LikeFall123/ImpedanceMeasMultiSine/Measurements/Multisine - Impedance/Impedancia mérés.docx

# Valós impedancián való mérés:

Párhuzamos/soros LR/CR impedancia mérése: L = 10 mH, C = 10 uF, R = 10 Ohm

## 1.2 darab szinusz. 5 paraméteres LSM illesztés:

f1 = 1 Hz, f2 = 10 Hz, fs = 1 kHz

Mikrovezérlő a mért impedancia alapján a kiválasztott modell paramétereit kiszámolja:

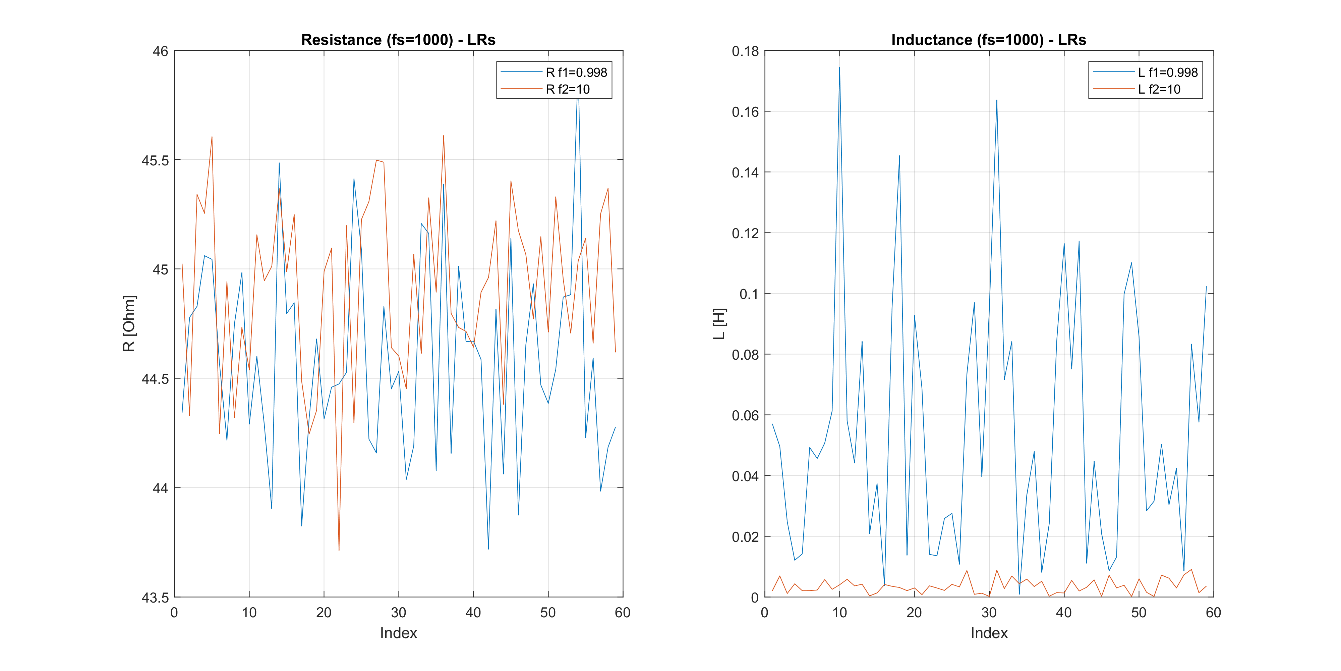
[picture p1: figure]
A képen szöveg, diagram, sor, Betűtípus látható Automatikusan generált leírás
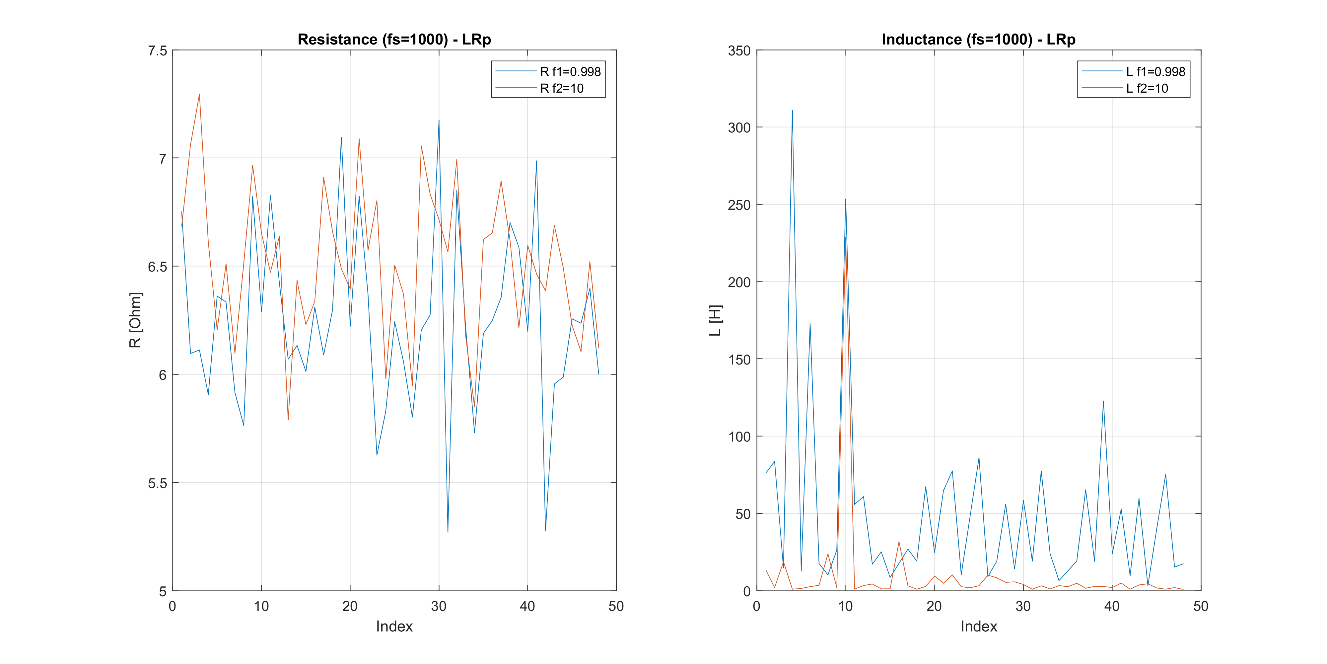
[picture p2: figure]
A képen szöveg, diagram, sor, Diagram látható Automatikusan generált leírás
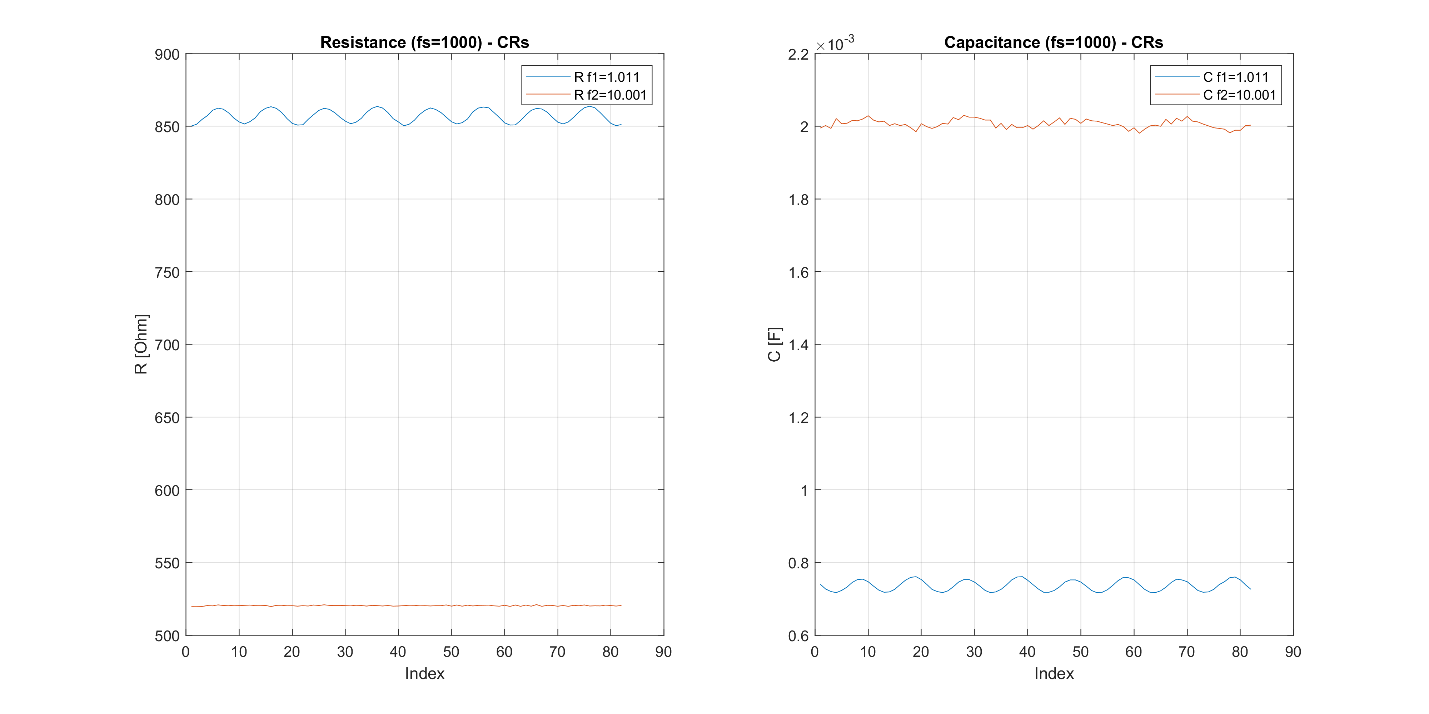
[picture p3: figure]
A képen szöveg, diagram, sor, Diagram látható Automatikusan generált leírás

C és S soros esetben 100 uF-al történt a mérés.

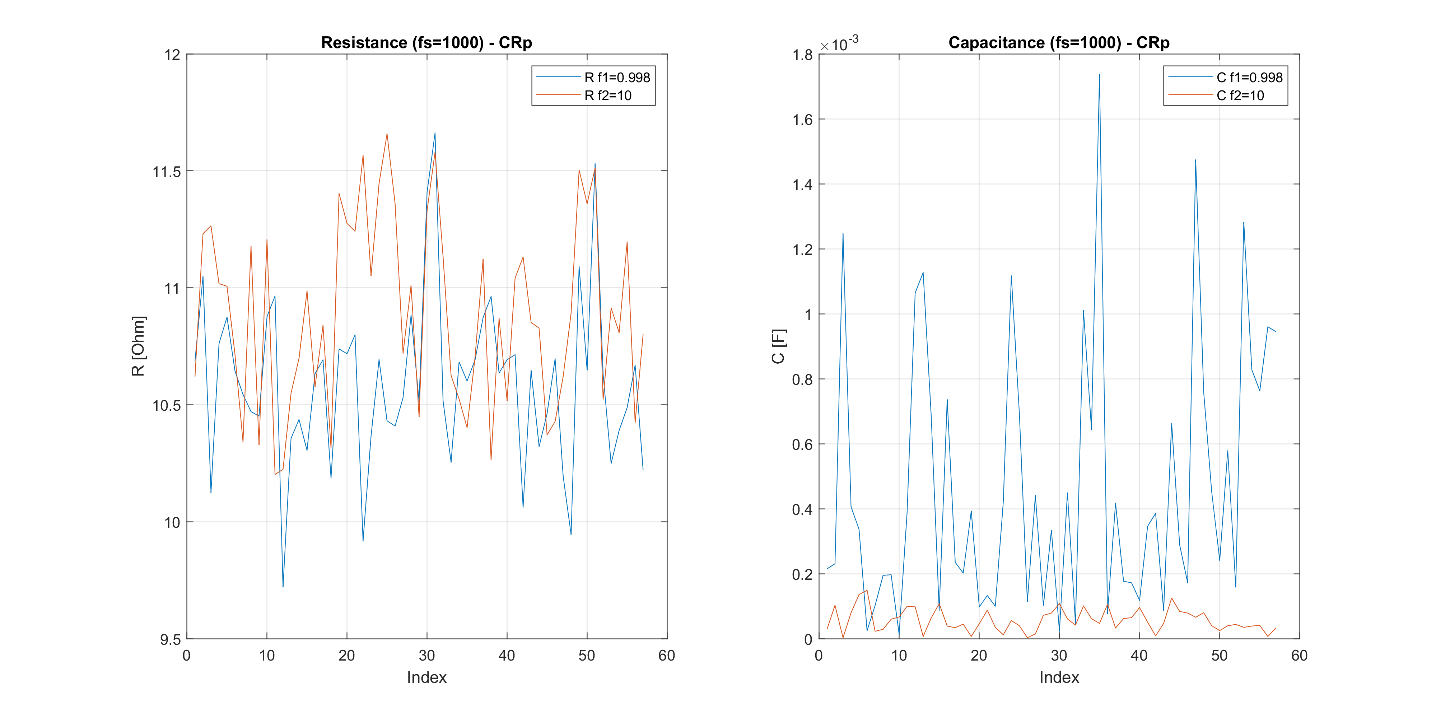
[picture p4: figure]
A képen szöveg, diagram, sor, Diagram látható Automatikusan generált leírás

## 2. Multiszinusz gerjesztés, majd FFT számolás

Legmegfelelőbbnek tűnő beállítás:

Bemenő jel: 10 Hz-től 200 Hz-ig, 10 Hz-enként egységnyi amplitúdójú szinuszok (random fázissal).

Az MCU kiszámolta az impedancia komplex spektrumát. MATLAB-ban kiértékelve a választott modell alapján.

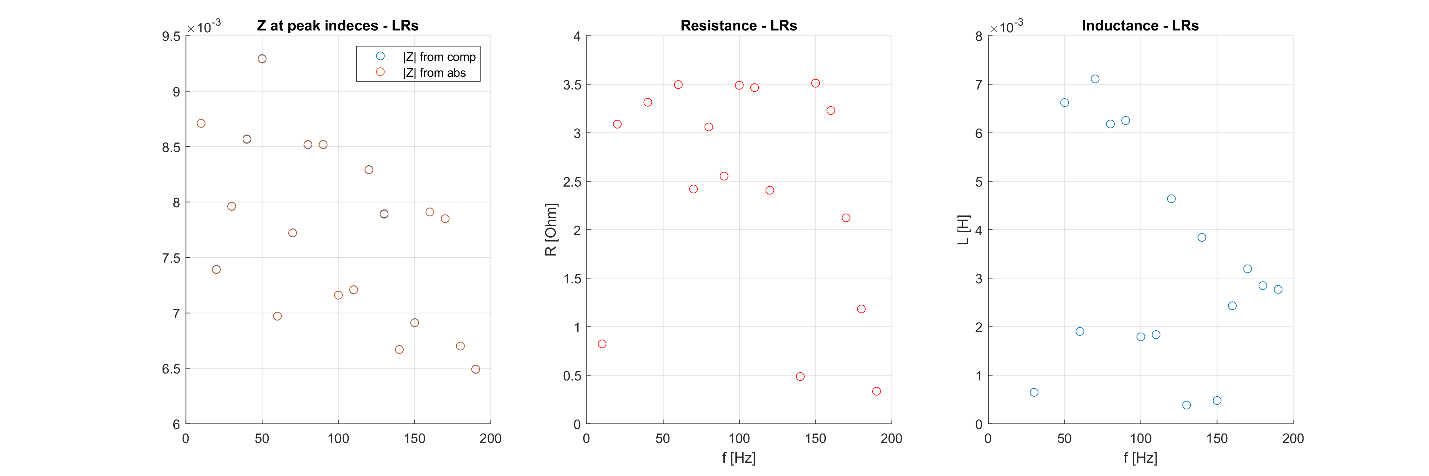
[picture p5: figure]
A képen szöveg, képernyőkép, diagram, sor látható Automatikusan generált leírás
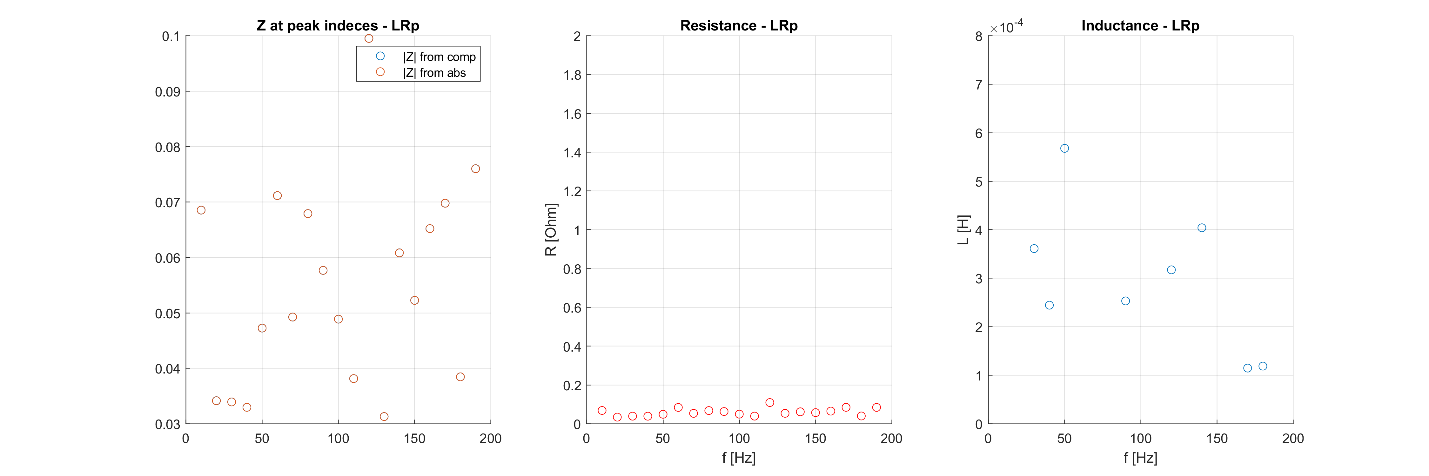
[picture p6: figure]
A képen szöveg, diagram, sor, képernyőkép látható Automatikusan generált leírás
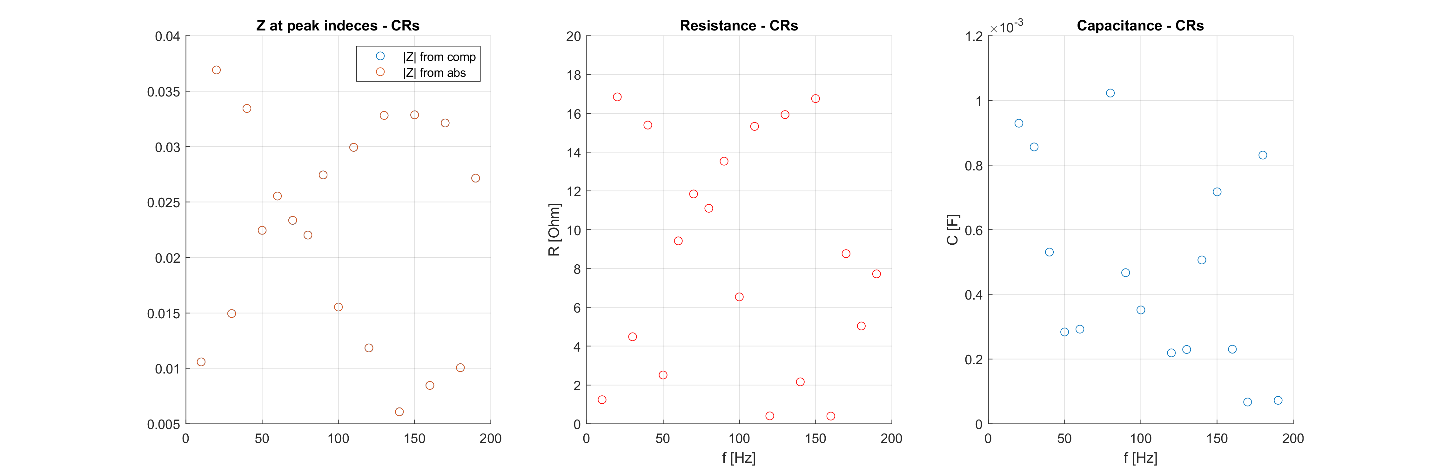
[picture p7: figure]
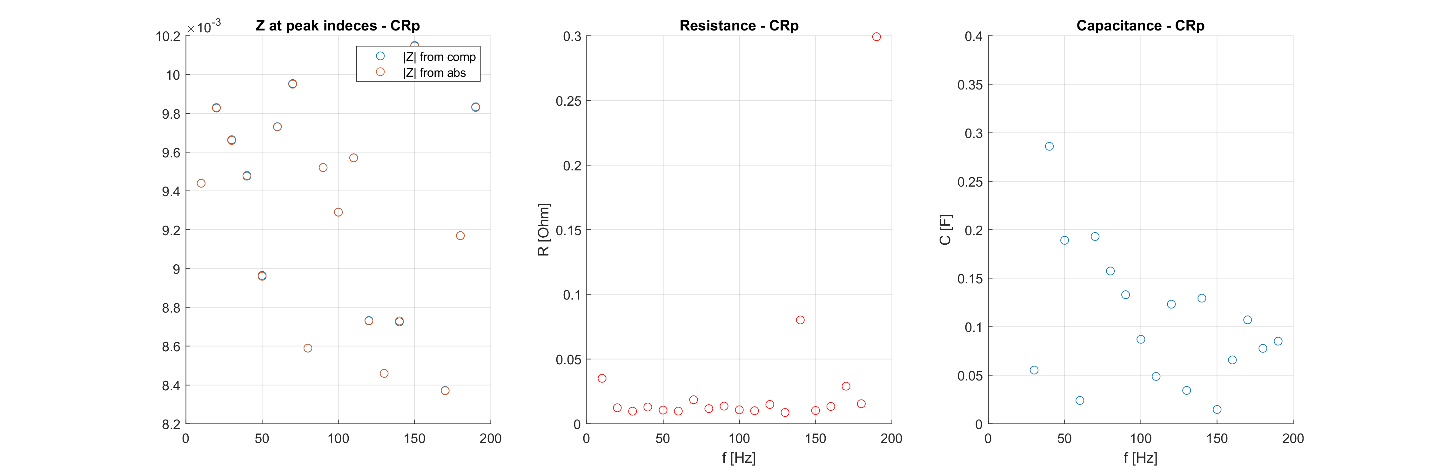
[picture p8: figure]
A képen szöveg, diagram, képernyőkép, sor látható Automatikusan generált leírás

Spektrum:

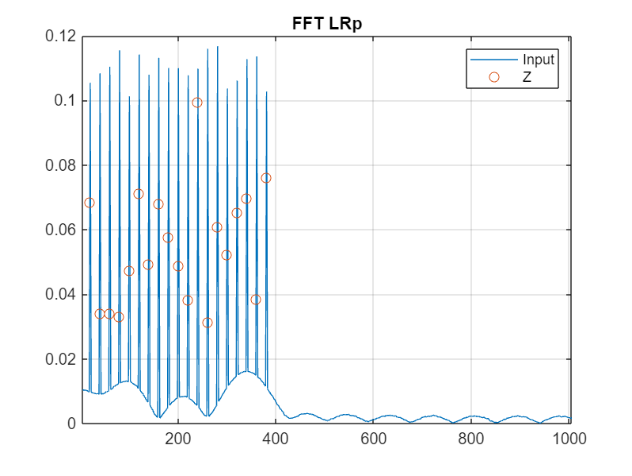
[picture p9: figure]
A képen szöveg, diagram, sor, Diagram látható Automatikusan generált leírás
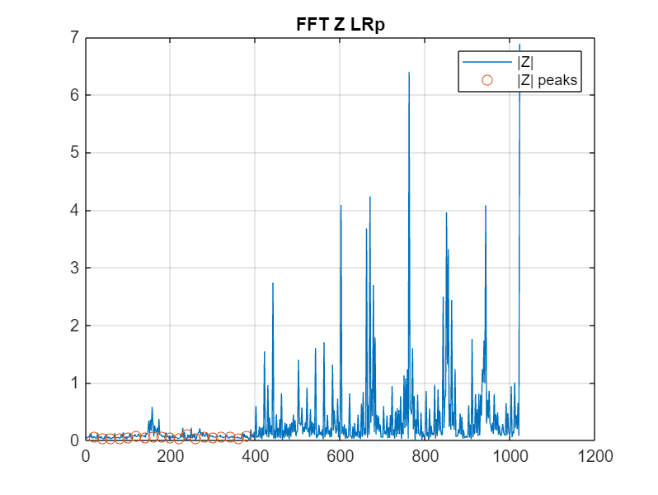
[picture p10: figure]
A képen szöveg, Diagram, sor, képernyőkép látható Automatikusan generált leírás

Bal oldali ábra: Kék a gerjesztő jel spektruma, amiben detektáljuk a komponenseket. Sárga körök a csúcs frekvenciákon az impedancia értéke.

Jobb oldali ábra: Az impedancia teljes spektruma (kék), és a csúcs frekvenciákon az értéke (sárga körök)
