LikeFall123/ImpedanceMeasMultiSine/Measurements/Signal generation and post processing/2 Sine/dac2SinFs1000Hz.xlsx

Sheet: 0.5
2.44761 | 0.58652 | 2.8311 | 0.31985 | 2.95356
2.40249 | 0.63003 | 2.78921 | 0.36174 | 2.91409
2.35576 | 0.67756 | 2.7449 | 0.40444 | 2.87219
2.30742 | 0.72429 | 2.69817 | 0.45037 | 2.82869
2.25747 | 0.77344 | 2.64983 | 0.49709 | 2.78437
2.2051 | 0.825 | 2.59988 | 0.54463 | 2.73684
2.15193 | 0.87656 | 2.54912 | 0.59539 | 2.6885
2.09795 | 0.92974 | 2.49675 | 0.64614 | 2.63936
2.04397 | 0.98372 | 2.44519 | 0.69609 | 2.59182
1.98918 | 1.0377 | 2.39041 | 0.74766 | 2.54026
1.93198 | 1.09409 | 2.33723 | 0.80083 | 2.49031
1.8772 | 1.14807 | 2.28245 | 0.8532 | 2.43794
1.82161 | 1.20286 | 2.23088 | 0.90557 | 2.38718
1.76602 | 1.25925 | 2.17529 | 0.95793 | 2.33562
1.71123 | 1.31243 | 2.12212 | 1.0095 | 2.28567
1.65645 | 1.36641 | 2.06975 | 1.06187 | 2.23572
1.60166 | 1.42039 | 2.01658 | 1.11262 | 2.18738
1.54768 | 1.47275 | 1.96582 | 1.16177 | 2.13823
1.49692 | 1.52351 | 1.91506 | 1.21091 | 2.0915
1.44697 | 1.57346 | 1.86592 | 1.25764 | 2.04558
1.39783 | 1.621 | 1.8208 | 1.30437 | 2.00208
1.34949 | 1.66853 | 1.77488 | 1.34788 | 1.96018
1.30518 | 1.71284 | 1.73057 | 1.39058 | 1.91829
1.26167 | 1.75554 | 1.68948 | 1.43005 | 1.87961
1.21978 | 1.79663 | 1.65081 | 1.46873 | 1.84417
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
