LikeFall123/ImpedanceMeasMultiSine/Measurements/Signal generation and post processing/2 Sine/dac2SinFs10kHz.xlsx

Sheet: 0.7
2.47339 | 0.73879 | 1.67336 | 0.95713 | 0.87898
2.72234 | 0.95471 | 1.84094 | 1.23992 | 1.10215
2.88025 | 1.08201 | 1.93843 | 1.4647 | 1.25684
2.91731 | 1.09248 | 1.92554 | 1.59763 | 1.31646
2.82546 | 0.97485 | 1.77246 | 1.58474 | 1.25925
2.64822 | 0.78311 | 1.52996 | 1.47517 | 1.07395
2.44036 | 0.57524 | 1.23669 | 1.29873 | 0.80808
2.25908 | 0.40767 | 0.95229 | 1.10054 | 0.53738
2.15354 | 0.32791 | 0.71462 | 0.97244 | 0.2989
2.18093 | 0.37866 | 0.61633 | 0.95471 | 0.13696
2.32192 | 0.55591 | 0.64373 | 1.05703 | 0.13293
2.54509 | 0.81211 | 0.7686 | 1.2657 | 0.24089
2.83271 | 1.13599 | 0.96841 | 1.58635 | 0.43345
3.06394 | 1.38977 | 1.16741 | 1.88364 | 0.655
3.19929 | 1.55574 | 1.29229 | 2.12776 | 0.87415
3.23555 | 1.6073 | 1.3084 | 2.27278 | 0.97888
3.12759 | 1.5356 | 1.2093 | 2.30098 | 0.97083
2.91328 | 1.36802 | 0.97485 | 2.19463 | 0.84836
2.674 | 1.17869 | 0.70576 | 2.02463 | 0.61794
2.44922 | 1.02319 | 0.43828 | 1.83772 | 0.36658
2.30259 | 0.94907 | 0.23203 | 1.69351 | 0.15872
2.26553 | 1.00305 | 0.12649 | 1.64275 | 0.03464
2.35898 | 1.1803 | 0.16113 | 1.72573 | 0.02578
2.54268 | 1.43972 | 0.30776 | 1.91748 | 0.16436
2.76343 | 1.74023 | 0.51804 | 2.19141 | 0.3843
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
