LikeFall123/ImpedanceMeasMultiSine/Measurements/Signal generation and post processing/Multisin/Multisin N freq/dacNfreqFFT.xlsx

Sheet: Absolute
1.66100,19.36076,1.66098,0.01138
0.66187,4.05388,0.66202,0.01196
0.07000,1.47349,0.06984,0.04121
0.06970,3.46037,0.06962,0.09707 | Amplitude
0.06926,0.64494,0.06927,0.01818
0.50991,3.17238,0.50989,0.01215
0.06826,1.03530,0.06832,0.02960
0.06755,3.26266,0.06761,0.09425
0.06678,1.81283,0.06688,0.05294
0.06594,0.75571,0.06589,0.02240
0.35679,3.31427,0.35706,0.01813
0.06415,2.04909,0.06398,0.06256
0.06311,0.47889,0.06316,0.01481
0.06244,1.21868,0.06241,0.03814
0.06171,0.57302,0.06162,0.01816
0.06108,1.35756,0.06099,0.04348
0.06032,1.65403,0.06034,0.05354
0.05969,2.58350,0.05975,0.08445
0.05904,2.44835,0.05905,0.08098
0.05824,2.07132,0.05833,0.06936
0.20844,1.95688,0.20869,0.01831
0.05625,1.74432,0.05613,0.06070
0.05449,1.81232,0.05462,0.06481
0.05256,1.11427,0.05268,0.04131
0.05033,2.19180,0.05030,0.08511
0.08537,2.31918,0.08541,0.05304
0.04417,0.81263,0.04418,0.03593
0.04052,0.79086,0.04053,0.03811
0.03661,1.95331,0.03655,0.10437
0.03240,1.60281,0.03248,0.09639
0.02784,0.52113,0.02786,0.03653
0.02316,2.90698,0.02327,0.24399
0.01872,0.83200,0.01868,0.08698
0.01413,1.31461,0.01410,0.18213
0.01015,2.03791,0.01009,0.39447
0.00652,2.19819,0.00641,0.67028
0.00438,1.81654,0.00439,0.80866
0.00450,1.66824,0.00468,0.69629
0.00648,0.96520,0.00654,0.28836
0.00827,1.01362,0.00829,0.23881
0.00985,1.46147,0.00976,0.29250
0.01094,0.43235,0.01086,0.07779
0.01138,1.51599,0.01135,0.26078
0.01137,0.37147,0.01139,0.06372
0.01075,1.61561,0.01085,0.29080
0.00995,1.76643,0.01000,0.34513
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
0.00106,1.03883,0.00097,2.09081
0.00107,1.85990,0.00118,3.09126
0.00111,0.86816,0.00122,1.39289
0.00105,1.61232,0.00115,2.74354
0.00094,1.50456,0.00103,2.84504
0.00094,1.72360,0.00095,3.55203
0.00066,0.64863,0.00078,1.63323
0.00051,1.46294,0.00062,4.61262
0.00000,0.00000,0.00000,0.00000

Sheet: Complex
1700.86475,-0.13214,19800.02344,-1003.06543,1700.84070,-0.26746,11.64141,-0.58792
130.08691,-312.91385,729.94312,-1943.00012,130.07639,-313.00073,6.11988,-0.21121
26.81174,23.78048,-683.97363,318.34360,26.70291,23.78144,-8.36337,19.37004
16.63279,31.57109,-1763.15601,-173.86562,16.50669,31.59425,-27.22743,41.58102 | Complex spectre
4.22584,35.20914,82.42249,-319.75467,4.27183,35.20804,-8.67019,-3.39298
261.07300,-0.70964,1182.55884,-1113.45264,261.06024,-0.76574,4.54230,-4.25179
-19.94205,28.69951,-463.49429,-257.19720,-19.99452,28.70088,1.54109,15.07553
-28.49495,19.59753,-1090.28259,-1265.62000,-28.54144,19.59182,5.27549,47.96453
-33.21756,8.09188,-706.80786,-601.59943,-33.26668,8.10610,15.89631,21.95760
-33.48565,-4.30555,371.17679,109.25935,-33.46404,-4.27075,-11.32406,-1.81978
22.62266,181.27094,-380.04871,1653.80017,22.65921,181.40756,8.71878,3.18404
-21.44400,-24.88084,810.09766,666.65186,-21.38548,-24.81096,-31.56295,5.44553
-10.99352,-30.38727,-244.70026,-15.51537,-10.95854,-30.42504,3.01558,-6.95657
0.74769,-31.95898,-256.27499,-568.90570,0.74788,-31.94568,17.61108,-8.43450
11.90076,-29.26811,242.53371,-165.08542,11.92219,-29.21104,7.74932,5.14001
21.34529,-22.85690,84.68404,689.89172,21.33058,-22.80274,-14.28272,17.07439
27.69743,-13.65899,819.47925,-213.61171,27.72298,-13.63092,26.85568,5.49926
30.40028,-3.11002,1254.40515,-419.68851,30.43606,-3.09880,42.18112,-9.49458
29.28323,7.49992,1200.85315,-359.65897,29.30823,7.41975,35.58579,-21.28060
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
0.22458,-0.40775,518.20618,472.87552,0.30023,-0.32877,0.57364,1575.69482
0.46035,-0.28933,-4.08017,531.86353,0.46161,-0.18380,-403.63364,991.48358
0.53434,-0.12090,912.54407,-272.18088,0.59457,-0.09213,1568.08008,-214.80731
0.56674,-0.01682,432.14667,104.04523,0.62179,0.04298,703.20844,118.72541
0.49432,0.20475,763.13702,-314.78235,0.55711,0.18707,1060.50537,-921.13281
0.38170,0.29687,689.12817,344.26099,0.43172,0.30543,1439.76990,-221.18079
0.30013,0.37743,613.91882,-633.93860,0.30787,0.37507,-207.12135,-1806.80823
0.10170,0.32096,95.22528,318.15182,0.10770,0.38226,836.10205,-13.54668
-0.04743,0.25652,257.88766,703.22858,-0.01492,0.31681,2176.55713,-916.53644
