LikeFall123/ImpedanceMeasMultiSine/Measurements/Signal generation and post processing/Multisin/Multisin White/dacWhiteFFT.xlsx

Sheet: Absolute
1.59204,18.25366,1.59180,0.01120 |  | 1.59153,19.18152,1.59153,0.01177 | 1.58978,15.92188,1.58961,0.00978
0.01904,0.61458,0.01895,0.06333 |  | 0.01894,0.77419,0.01889,0.08003 | 0.01675,1.27735,0.01681,0.14844
0.02164,1.18334,0.02165,0.10678 |  | 0.02161,1.15691,0.02166,0.10430 | 0.02219,3.39908,0.02220,0.29900
0.02529,1.73806,0.02523,0.13456 |  | 0.02530,1.90458,0.02513,0.14801 | 0.02808,1.13091,0.02803,0.07880
0.02891,0.77423,0.02901,0.05213 |  | 0.02898,0.14447,0.02887,0.00977 | 0.03327,0.51856,0.03333,0.03039
0.03244,1.25754,0.03245,0.07569 | Absolute | 0.03250,2.38229,0.03250,0.14317 | 0.03729,1.29871,0.03740,0.06783
0.03547,2.44098,0.03537,0.13481 |  | 0.03539,1.82435,0.03547,0.10047 | 0.03984,1.74338,0.03985,0.08546
0.03767,2.04956,0.03775,0.10603 |  | 0.03775,0.63945,0.03778,0.03306 | 0.04058,0.47189,0.04055,0.02273
0.03895,0.86343,0.03912,0.04311 |  | 0.03897,2.26939,0.03912,0.11332 | 0.03970,1.34319,0.03977,0.06597
0.03963,1.50197,0.03962,0.07405 |  | 0.03962,0.47419,0.03958,0.02340 | 0.03760,2.50670,0.03751,0.13054
0.17989,2.08727,0.18000,0.02265 |  | 0.17986,3.04211,0.18000,0.03301 | 0.18680,2.35156,0.18679,0.02459
0.03808,0.83171,0.03818,0.04255 |  | 0.03808,2.73960,0.03818,0.14013 | 0.03066,1.40647,0.03061,0.08974
0.03631,0.50812,0.03630,0.02734 |  | 0.03631,0.78479,0.03624,0.04229 | 0.02740,0.85397,0.02750,0.06065
0.03394,0.67821,0.03396,0.03900 |  | 0.03390,2.32909,0.03400,0.13378 | 0.02553,0.56117,0.02566,0.04271
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
0.00135,2.34631,0.00133,3.43559
0.00133,1.06160,0.00131,1.57782
0.00115,1.12168,0.00125,1.75545
0.00116,1.30688,0.00116,2.20614
0.00105,1.52582,0.00122,2.43846
0.00108,1.39676,0.00110,2.47456
0.00110,1.57203,0.00122,2.50735
0.00125,4.73112,0.00100,9.21938
0.00000,0.00000,0.00000,0.00000

Sheet: Complex
1628.06091,-0.63562,17371.34766,52.87109,1627.91260,-0.70654,10.67092,0.03711 | 1629.72461,0.52368,19641.59375,105.60059,1629.73108,0.52368,12.05207,0.06092 | 1627.93530,-0.64374,16262.57324,1161.54590,1627.76123,-0.58893,9.99050,0.71720
5.42123,6.71934,-355.00723,-420.58762,5.43438,6.71344,-63.70854,1.30945 | 8.07197,5.37118,306.69608,-251.11206,8.04706,5.36987,11.96232,-39.18798 | 5.39875,6.66134,94.16238,647.19110,5.37447,6.72072,65.57011,38.42480
0.04159,11.28935,-1355.14880,975.04846,-0.03781,11.35583,86.25956,119.04783 | 4.92861,9.90615,564.25519,-180.21687,4.97304,9.91433,8.28558,-52.75704 | -0.01601,11.36317,-1083.88098,1361.59814,-0.03652,11.36811,120.07848,94.95826
-7.28186,12.34779,-1012.63757,75.42731,-7.39136,12.40198,40.39612,57.57594 | 0.20050,12.95146,401.55994,-888.62848,0.23622,12.86594,-68.47218,-32.46822 | -7.29347,12.39000,-571.49341,-93.08634,-7.31102,12.34991,14.70395,37.57052 | Complex spectre
-14.29975,9.29594,346.40155,-98.78839,-14.29109,9.27742,-20.20957,-6.20697 | -5.37955,13.82925,59.44132,-44.02529,-5.35275,13.78049,-4.23175,-2.66970 | -14.30276,9.24782,233.14636,-127.02624,-14.31516,9.28762,-15.51357,-1.19160
-18.92851,2.83493,-186.74722,-24.41732,-18.88411,2.80585,9.48755,2.70269 | -10.91315,12.55832,611.47461,-1055.39185,-10.97676,12.50570,-71.90946,14.22221 | -18.88500,2.81981,-192.09987,636.58435,-18.93634,2.83260,14.84106,-31.39707
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
-4.68113,2.95817,-225.71042,-292.74365,-4.73814,2.90856,7.05240,66.11364 | -6.03340,7.78847,346.21088,614.43921,-5.99533,7.79141,28.05688,-66.02418 | -4.71848,2.99808,323.85077,631.85767,-4.69725,3.03225,12.62835,-126.36454
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
