LikeFall123/ImpedanceMeasMultiSine/Imp_measure corrected/prev_without_halfDC.png

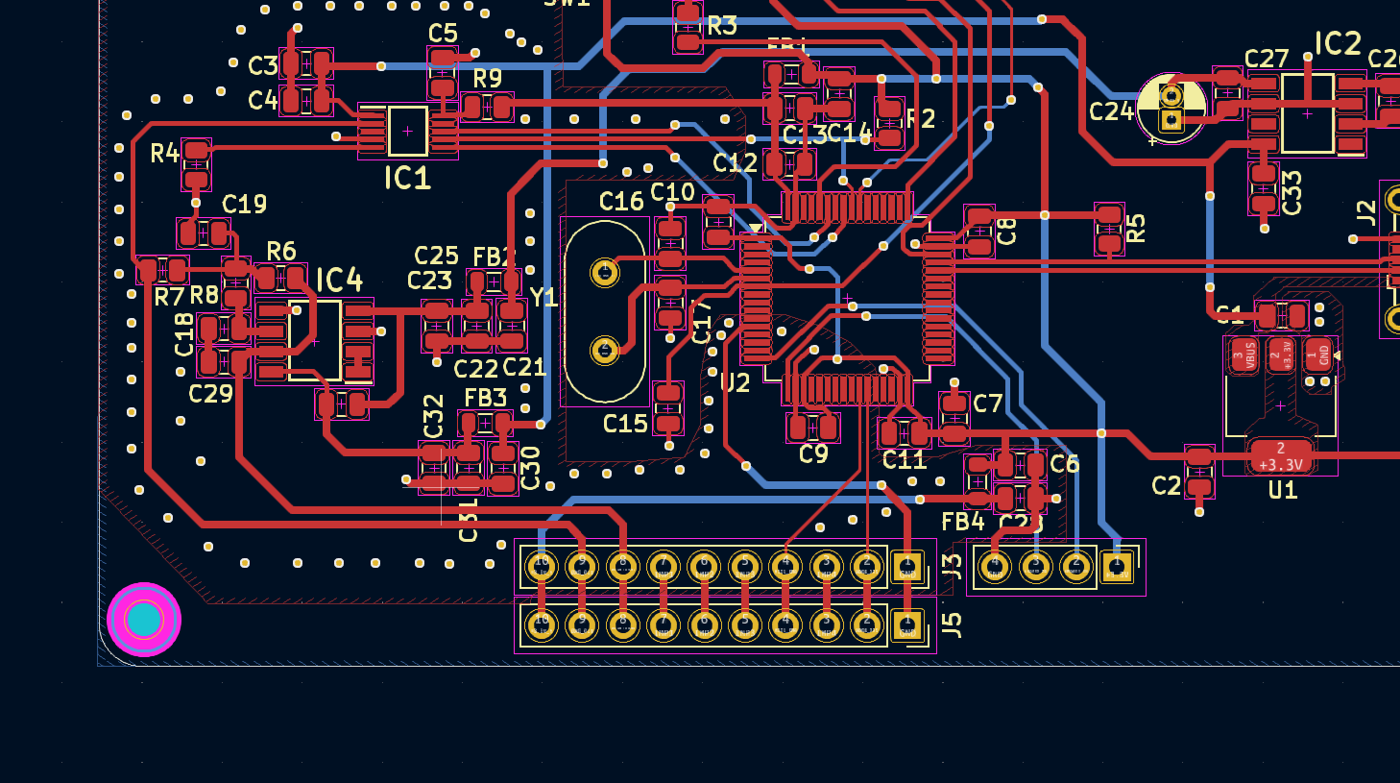
Imp_measure corrected/prev_without_halfDC.png
