LikeFall123/ImpedanceMeasMultiSine/Measurements/Multisine - Impedance/whiteMultiSin/Doc/CRp_plot.png

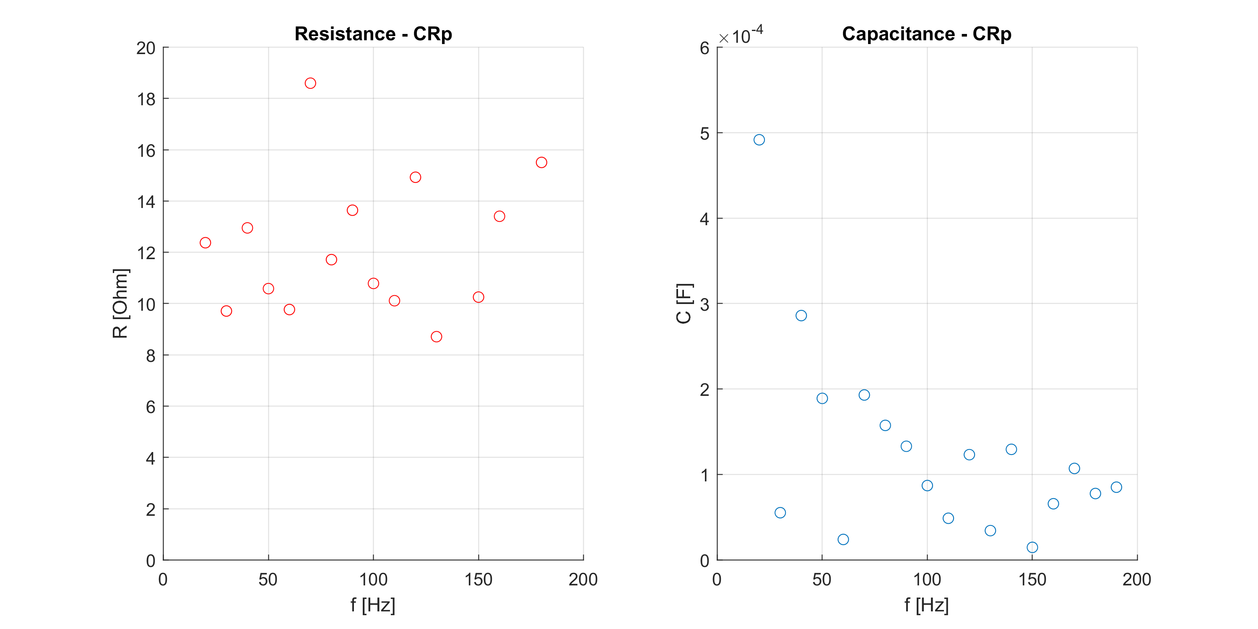
Measurements/Multisine - Impedance/whiteMultiSin/Doc/CRp_plot.png
