LikeFall123/ImpedanceMeasMultiSine/Measurements/Multisine - Impedance/whiteMultiSin/Doc/CRs_plot.png

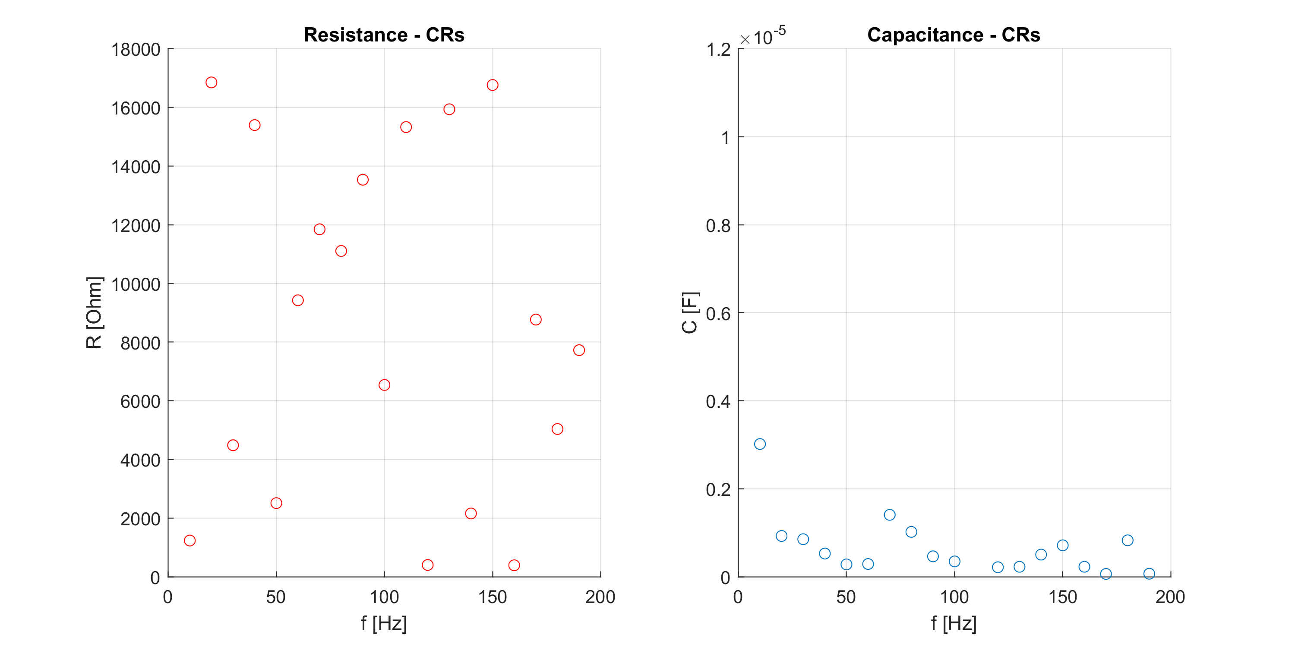
Measurements/Multisine - Impedance/whiteMultiSin/Doc/CRs_plot.png
