LikeFall123/ImpedanceMeasMultiSine/Measurements/Multisine - Impedance/whiteMultiSin/Doc/LRp_plot.png

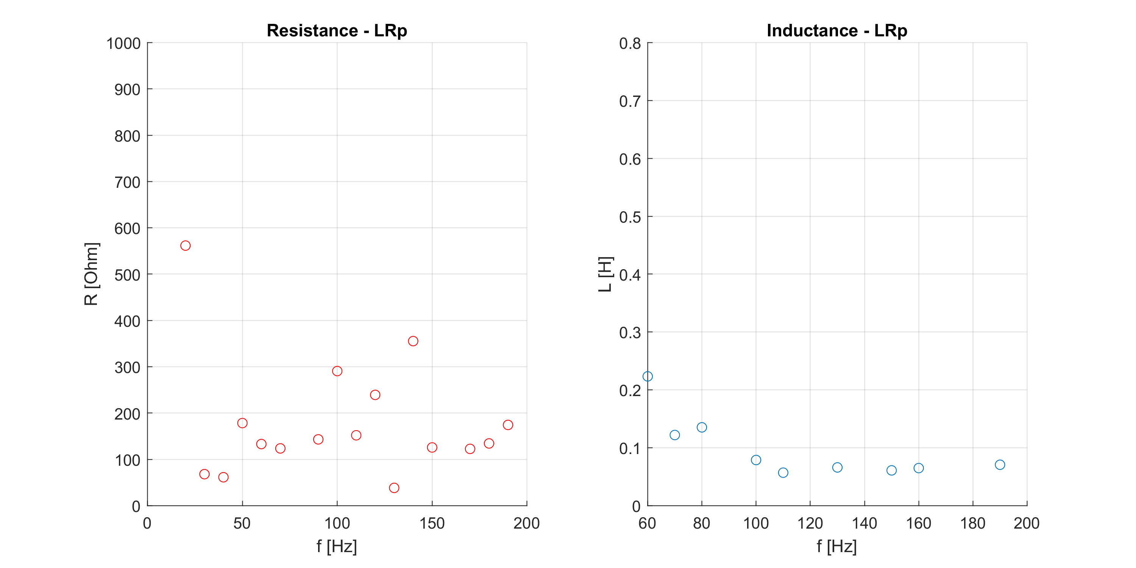
Measurements/Multisine - Impedance/whiteMultiSin/Doc/LRp_plot.png
