LikeFall123/ImpedanceMeasMultiSine/Measurements/Multisine - Impedance/whiteMultiSin/Doc/LRs_plot.png

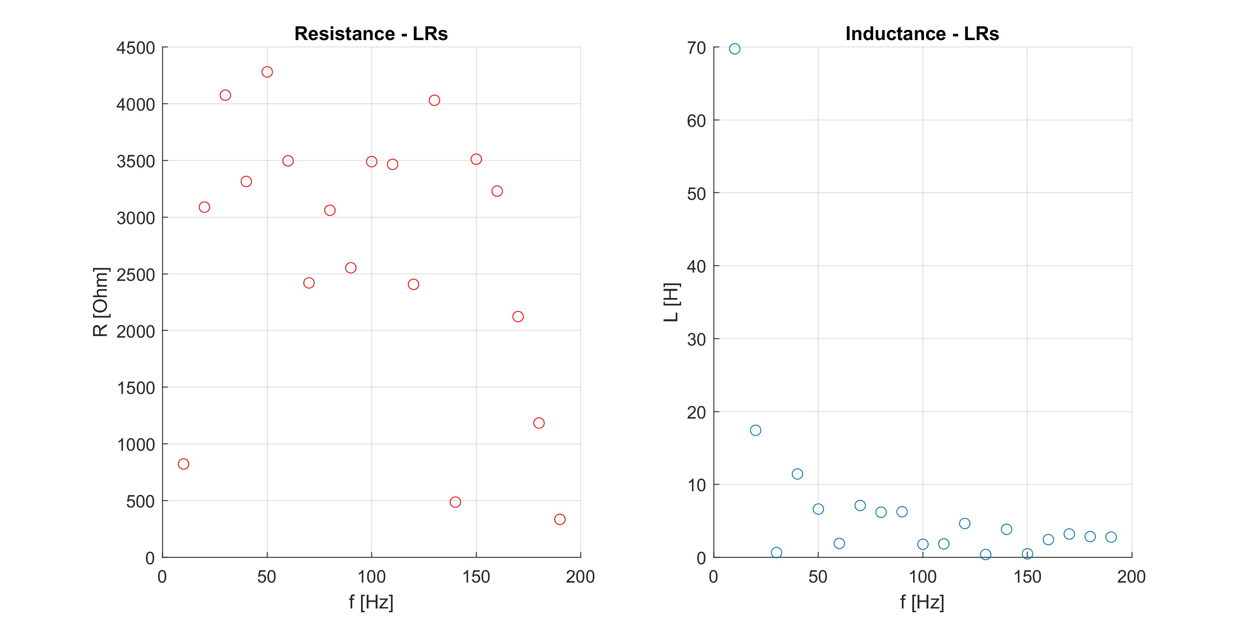
Measurements/Multisine - Impedance/whiteMultiSin/Doc/LRs_plot.png
