LikeFall123/ImpedanceMeasMultiSine/Measurements/Signal generation and post processing/2 sine with attempted register split/multisin_opt_meres.png

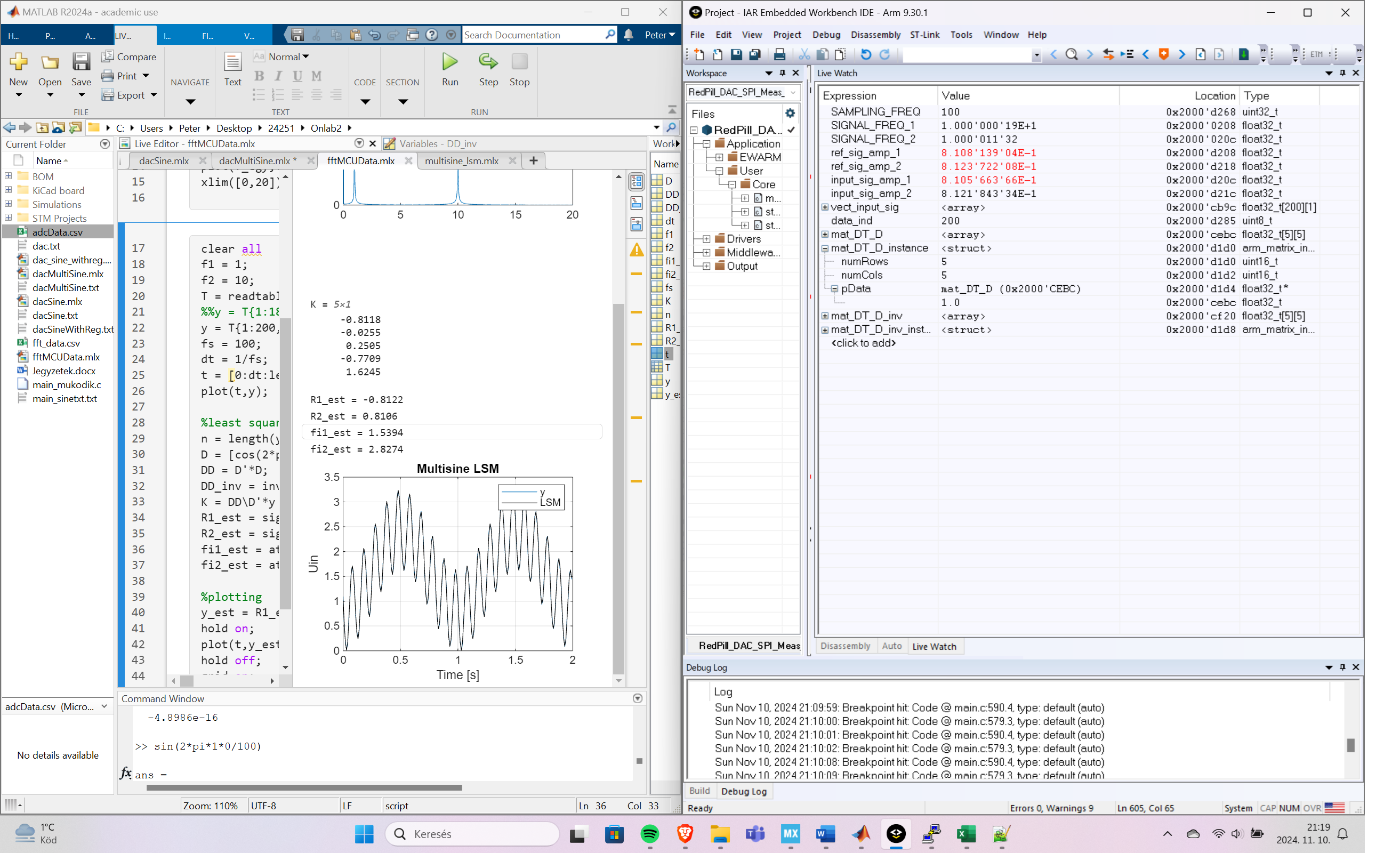
Measurements/Signal generation and post processing/2 sine with attempted register split/multisin_opt_meres.png
