LikeFall123/ImpedanceMeasMultiSine/Measurements/Signal generation and post processing/Multisin/MultisinFFT/freq_detect.png

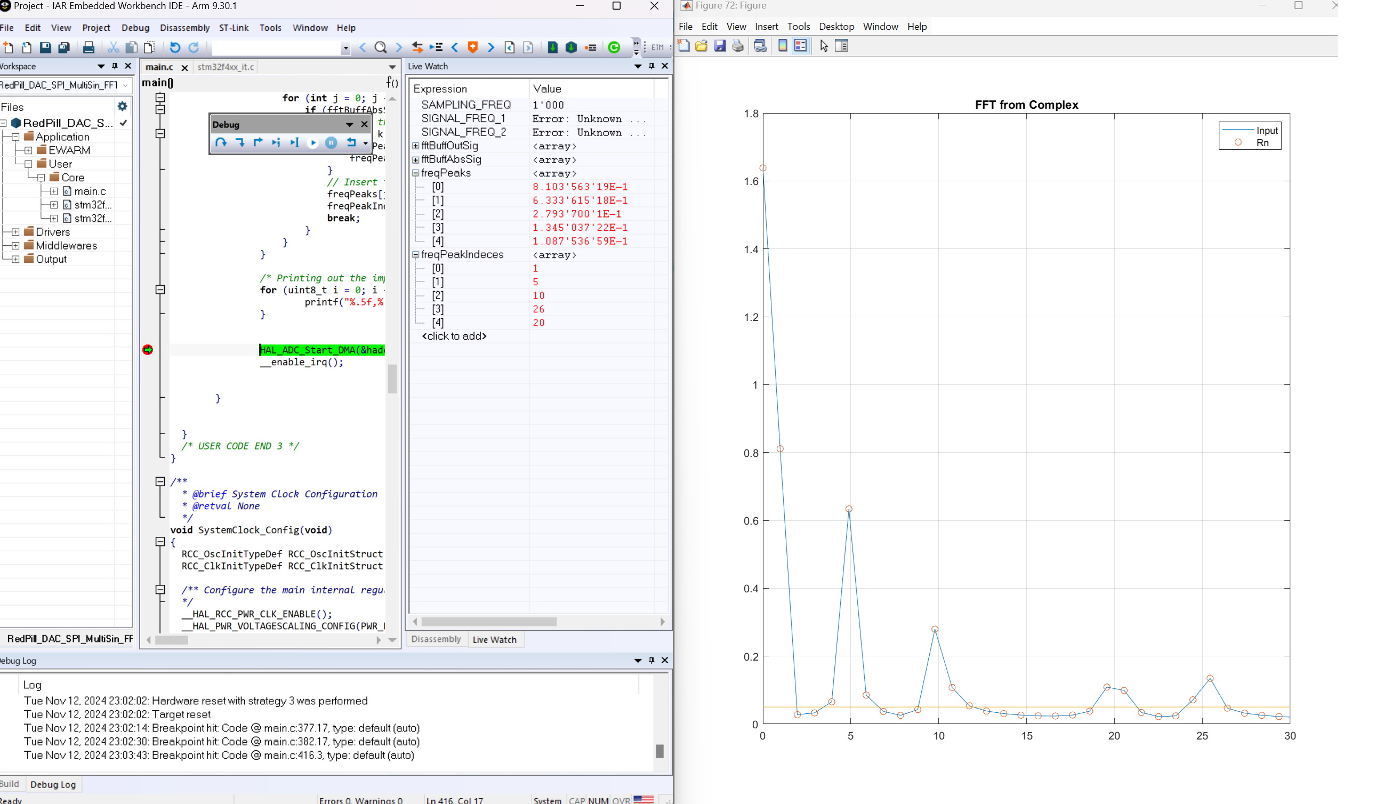
Measurements/Signal generation and post processing/Multisin/MultisinFFT/freq_detect.png
