LikeFall123/ImpedanceMeasMultiSine/Measurements/Signal generation and post processing/Multisin/MultisinFFT/freq_detect_coherent.png

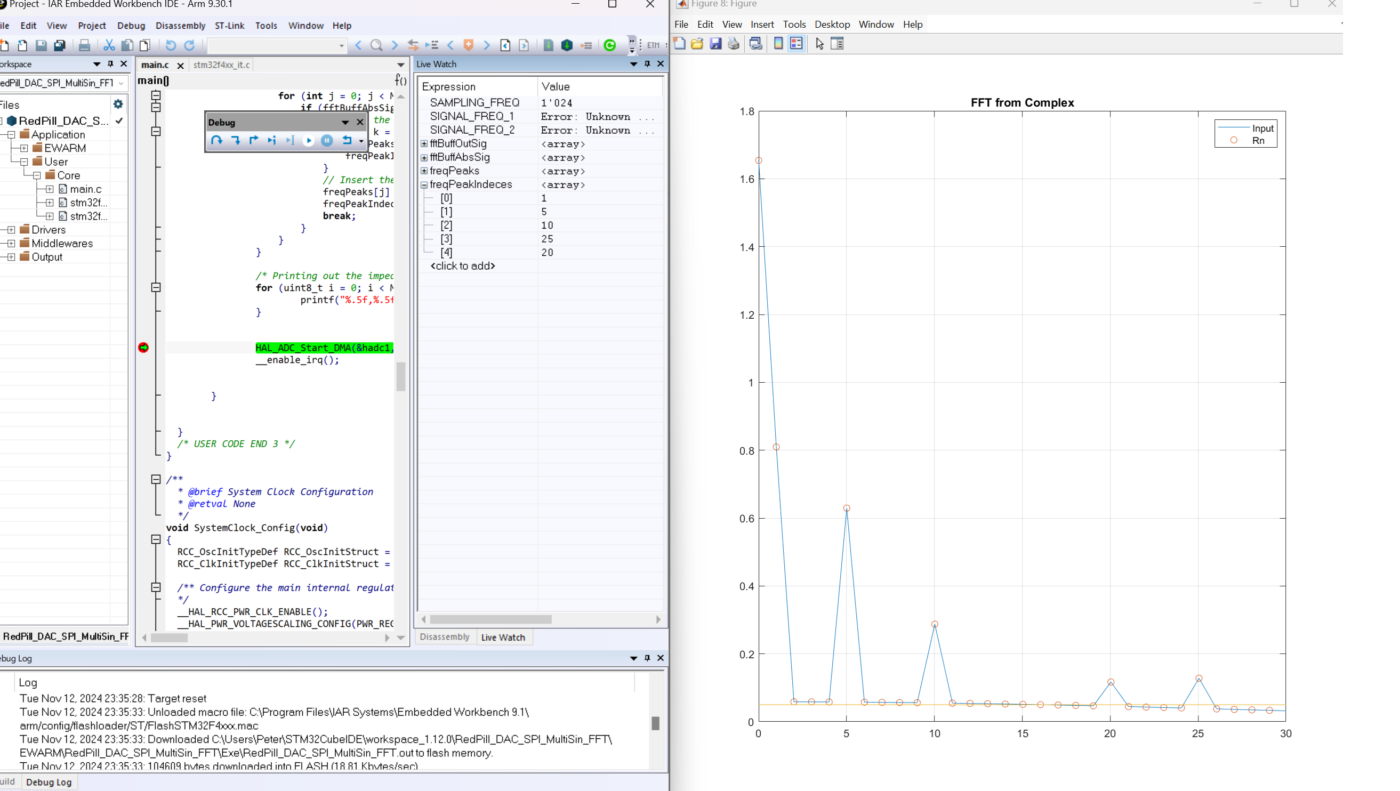
Measurements/Signal generation and post processing/Multisin/MultisinFFT/freq_detect_coherent.png
