LikeFall123/ImpedanceMeasMultiSine/Imp_measure corrected/imp_measure.kicad_pcb

## KiCad design Imp_measure corrected/imp_measure.kicad_pcb (2024-12-18)

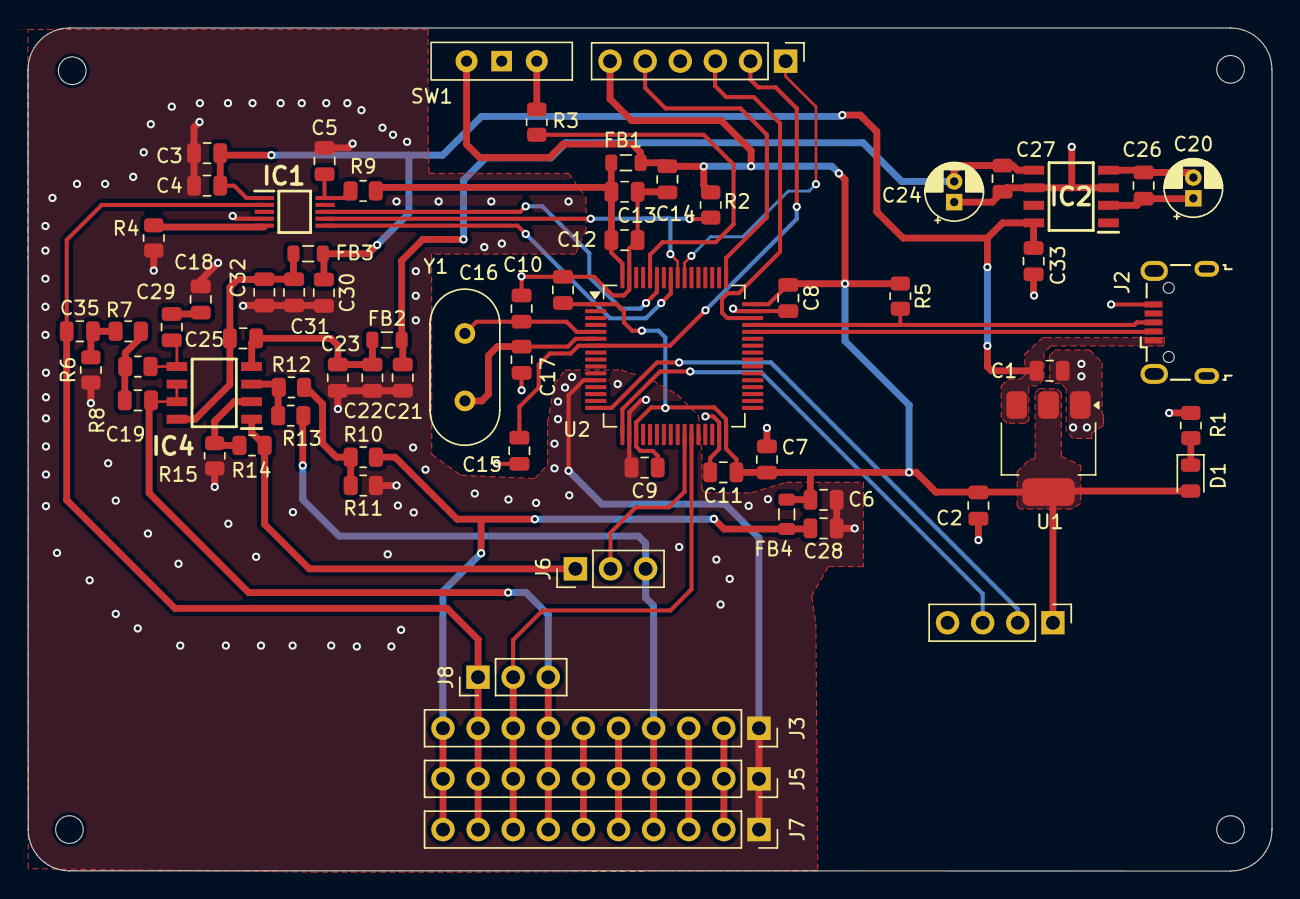
[picture p46: board imp_measure.kicad_pcb from above]

Board: 2 copper layers, 90.0 x 61.0 mm, 73 parts (0 on the bottom side), 45 nets.

Parts:
C1, C2: 22u; C_0805_2012Metric
C3, C7, C35: 10u; C_0805_2012Metric
C4, C8, C9, C10, C11, C15, C25: 100n; C_0805_2012Metric
C5: 330n; C_0805_2012Metric
C6, C13, C14, C21, C22, C26, C27, C28, C30, C31, C33: 1u; C_0805_2012Metric
C12, C23, C32: 10n; C_0805_2012Metric
C16, C17: 10p; C_0805_2012Metric
C18, C19, C29: 1n; C_0805_2012Metric
C20, C24: 150u; CP_Radial_D4.0mm_P1.50mm
D1: LED; LED_0805_2012Metric
FB1, FB2, FB3, FB4: 120R; L_0805_2012Metric
H1, H2, H3, H4: MountingHole; MountingHole_2mm
IC1: DAC80501ZDGST; SOP50P490X110-10N
IC2: MAX660MX_NOPB; SOIC127P600X175-8N
IC4: MC33202DR2G; SOIC127P600X175-8N
J1: Conn_01x04_Pin; PinHeader_1x04_P2.54mm_Vertical
J2: USB_B_Micro; USB_Micro-B_Wuerth_629105150521
J3, J5, J7: Conn_01x10_Pin; PinSocket_1x10_P2.54mm_Vertical
J4: Conn_01x06_Pin; PinHeader_1x06_P2.54mm_Vertical
J6, J8: Conn_01x03_Pin; PinHeader_1x03_P2.54mm_Vertical
R1, R5, R9: 1k5; R_0805_2012Metric
R2, R3, R4, R6: 10k; R_0805_2012Metric
R7: 5k; R_0805_2012Metric
R8, R10, R11: 1k; R_0805_2012Metric
R12, R13, R14, R15: 10M; R_0805_2012Metric
SW1: SW_SPDT; SW_Slide-03_Wuerth-WS-SLTV_10x2.5x6.4_P2.54mm
U1: AMS1117-3.3; SOT-223-3_TabPin2
U2: STM32F401RCT6; LQFP-64_10x10mm_P0.5mm
Y1: Crystal; Crystal_HC49-U_Vertical

Connections:
+3.3V: C2.1, C6.1, C7.1, C8.1, C9.1, C10.1, C11.1, C14.1, D1.2 (A), FB1.2, FB4.2, J1.1, J4.6, R2.1, R5.1, SW1.3 (C), U1.2 (VO), U2.1 (VBAT), U2.19 (VDD), U2.32 (VDD), U2.48 (VDD)
+3.3VA: C12.1, C13.1, FB1.1, R9.1, U2.64 (VDD)
+3.3V_F: C28.1, FB4.1, J3.10, J5.10, J7.10, R10.2
/ADC1_IN4_SIGNAL: J3.4, J5.4, J6.3, J7.4, R13.2
/ADC1_IN5: J3.8, J5.8, J7.8, J8.2, U2.27 (PB1)
/ADC_IN4: J6.2, U2.26 (PB0)
/ADC_IN4_MID: IC4.1 (OUTPUT_1), J6.1, R14.1
/DAC_OUT: C35.1, IC1.2 (VOUT), J3.9, J5.9, J7.9, J8.1
/DAC_OUT_FILTERED: C19.2, IC4.6 (INPUTS_2_2), IC4.7 (OUTPUT_2), J3.7, J5.7, J7.7, J8.3
/IMP1: J3.6, J5.6, J7.6
/IMP2: J3.5, J5.5, J7.5
/IMP3: J3.2, J5.2, J7.2
/IMP4: J3.3, J5.3, J7.3
/NRST: C15.1, J4.2, U2.7 (NRST)
/PWR_LED_K: D1.1 (K), R1.1
/RCC_OSC_IN: C16.1, U2.5 (PH0), Y1.1
/RCC_OSC_OUT: C17.1, U2.6 (PH1), Y1.2
/SPI1_MOSI: IC1.8 (SDIN/SDA), U2.59 (PB7)
/SPI1_NSS: IC1.7 (~SYNC/A0), R2.2, U2.56 (PB4)
/SPI1_SCK: IC1.6 (SCLK/SCL), U2.57 (PB5)
/SYS_JTCK_SWCLK: J4.5, U2.49 (PA14)
/SYS_JTDO_SWO: J4.1, U2.55 (PB3)
/SYS_JTMS_SWDIO: J4.3, U2.46 (PA13)
/USART2_RX: J1.3, U2.17 (PA3)
/USART2_TX: J1.2, U2.16 (PA2)
/USB_OTG_FS_D+: J2.3 (D+), R5.2, U2.45 (PA12)
/USB_OTG_FS_D-: J2.2 (D-), U2.44 (PA11)
/VF_MID: R10.1, R11.2, R12.2
GND: C1.2, C2.2, C3.2, C4.2, C5.2, C6.2, C7.2, C8.2, C9.2, C10.2, C11.2, C12.2, C13.2, C14.2, C15.2, C16.2, C17.2, C18.1, C21.2, C22.2, C23.2, C24.1, C27.2, C28.2, C30.2, C31.2, C32.2, C33.1, IC1.4 (AGND), IC2.3 (GND), IC2.6 (LV), J1.4, J2.5 (GND), J3.1, J4.4, J5.1, J7.1, R1.2, R4.2, R6.1, R11.1, R15.2, SW1.1 (A), U1.1 (GND), U2.12 (VSSA), U2.18 (VSS), U2.31 (VSS), U2.47 (VSS), U2.63 (VSS)
unnamed: C18.2, C29.1
unnamed: C19.1, R7.2, R8.1
unnamed: C35.2, R6.2, R7.1
unnamed: IC1.5 (SPI2C), R4.1
unnamed: C5.1, IC1.10 (VREFIO), R9.2
unnamed: C20.1, C26.1, IC2.2 (CAP+)
unnamed: C20.2, C26.2, IC2.4 (CAP-)
unnamed: IC4.2 (INPUTS_1_1), R14.2, R15.1
unnamed: IC4.3 (INPUTS_1_2), R12.1, R13.1
unnamed: C29.2, IC4.5 (INPUTS_2_1), R8.2
unnamed: R3.1, SW1.2 (B)
unnamed: R3.2, U2.60 (BOOT0)
VBUS: C1.1, C3.1, C4.1, C30.1, C33.2, FB3.2, IC1.1 (VDD), IC2.8 (V+), J2.1 (VBUS), U1.3 (VI)
VBUS_M: C21.1, C24.2, C27.1, FB2.2, IC2.5 (OUT)
VBUS_MF: C22.1, C23.1, C25.2, FB2.1, IC4.4 (VEE)
VBUS_PF: C25.1, C31.1, C32.1, FB3.1, IC4.8 (VCC)
