LikeFall123/ImpedanceMeasMultiSine/MultiSinLSM5/RedPill_DAC_SPI_Meas_MultiSin_Opt.ioc

Mcu.UserName=STM32F401RCTx
PA13.Signal=SYS_JTMS-SWDIO
PA14.Signal=SYS_JTCK-SWCLK
PA15.Signal=GPIO_Input
PA2.Signal=USART2_TX
PA3.Signal=USART2_RX
PA4.Signal=GPIO_Input
PA5.Signal=SPI1_SCK
PA6.Signal=GPIO_Input
PA7.Signal=SPI1_MOSI
PB0.Signal=ADCx_IN8
PB1.Signal=ADCx_IN9
PB10.Signal=GPIO_Input
PB2.Signal=GPIO_Input
PB4.GPIO_Label=SPI_SW_NSS
PB4.Signal=GPIO_Output
PB5.Signal=GPIO_Input
PC10.Signal=GPIO_Input
PC11.Signal=GPIO_Input
PC12.Signal=GPIO_Input
PC4.Signal=GPIO_Input
PC5.Signal=GPIO_Input
