LikeFall123/ImpedanceMeasMultiSine/(commit log)

2024-12-18 KiCad project
    The designed hardware in KiCad. It is the corrected version:
    -SPI connection
    -Vcap and Vref+
    -Sallen-Key without highpass
    (SPDT should be corrected)
    [imp_meas_bom.csv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]
2024-12-18 Multisine measurement C project
    EWARM project C code with STMCubeMX configurations. Measuring impedance with multisine excitation using a DAC80501 and a STM32F401 MCU.
2024-12-18 Impedance measurement with 5 param LSM.
    EWARM project C code with STMCubeMX configurations. Measuring impedance with multisine excitation using a DAC80501 and a STM32F401 MCU. The excitation contains 2 sines, and the MCU uses the 5 parameter LSM to determine its properties.
2024-12-18 MATLAB files
    MATLAB files for signal generation and post processing of the MCU data sent on serial port.
    Measurement data series of the impedance.
    [absSpectres.csv, absSpectres1024Hz1024.csv, absSpectres1kHz.csv, absSpectres512.csv, adcData.csv, complexSpectres.csv, complexSpectres1024Hz1024.csv, complexSpectres1kHz.csv]
2024-12-18 Impedance measurement data
    Data measured with different impedance models and sampling it with different frequencies.
    [CRp.csv, CRp1.csv, CRp2.csv, CRp3.csv, CRp4.csv, CRp5.csv, CRp6.csv, CRp_sig.csv]
